Kracav4ik/tmi/cpu_init_fsm.png

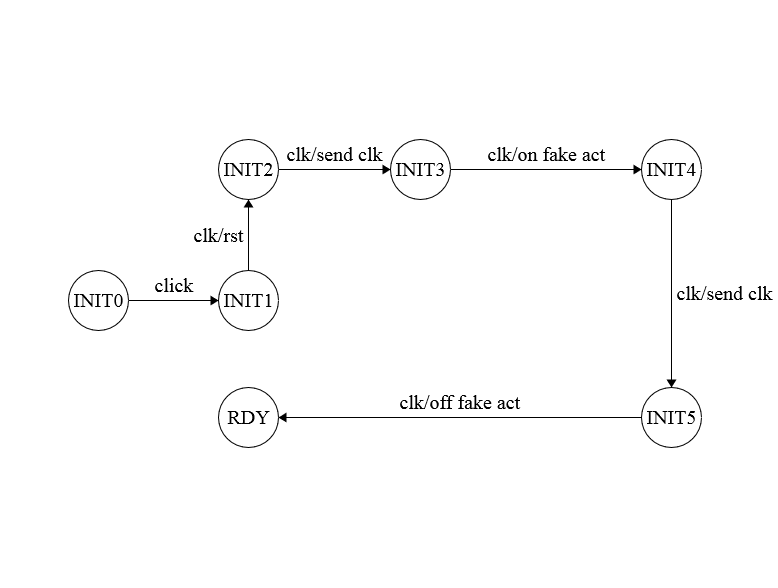
cpu_init_fsm.png
