Kracav4ik/tmi/cpu_jmp_fsm.png

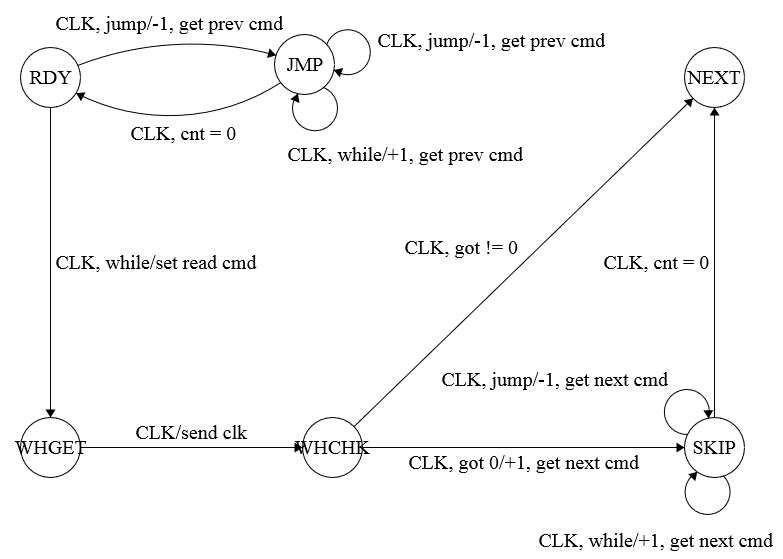
cpu_jmp_fsm.png
