Kracav4ik/tmi/cpu_kbd_fsm.png

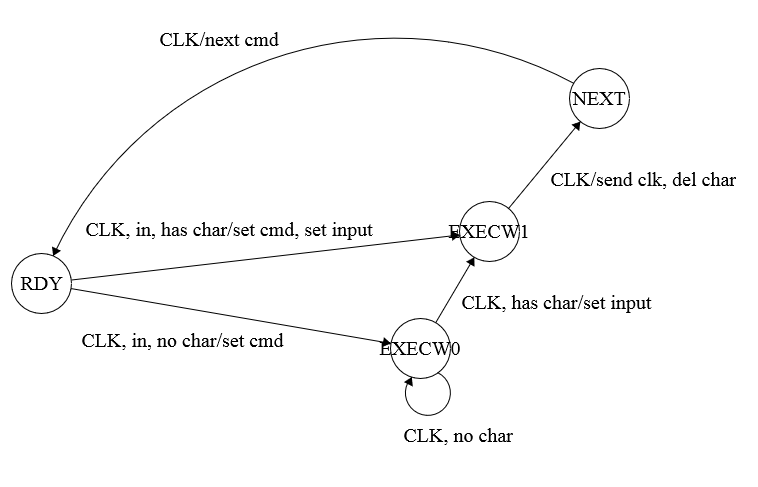
cpu_kbd_fsm.png
