Kracav4ik/tmi/cpu_simple_fsm.png

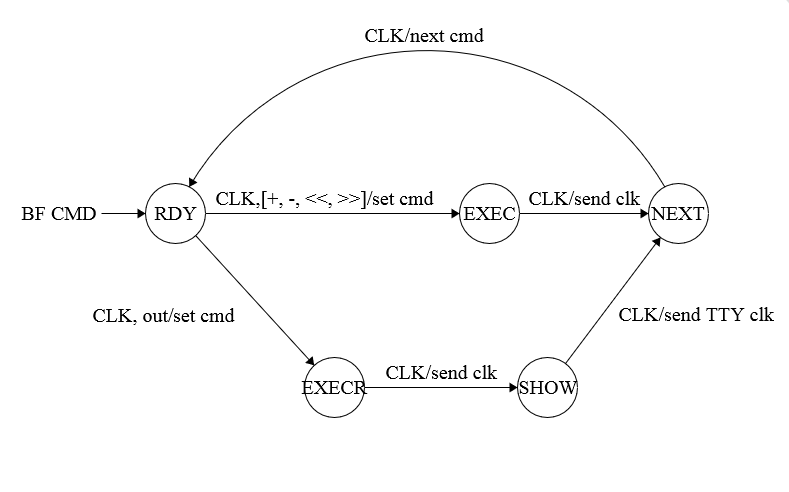
cpu_simple_fsm.png
