Kracav4ik/tmi/pics/02.png

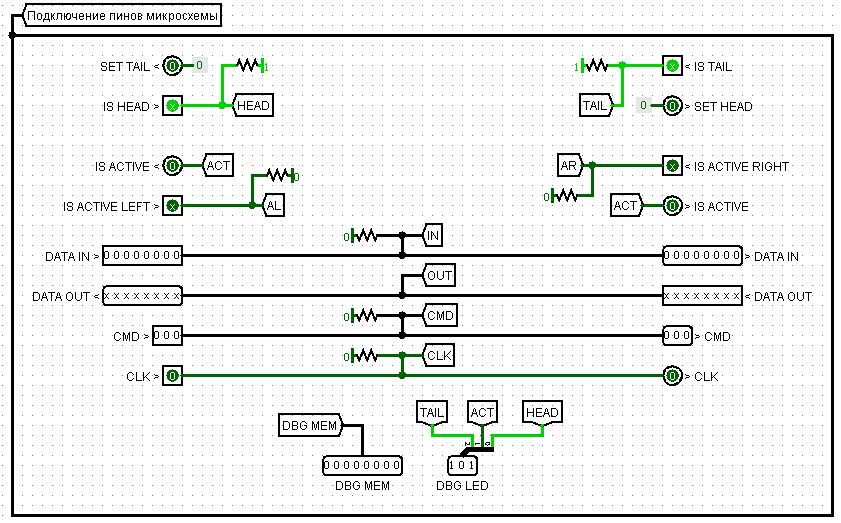
pics/02.png
