Kracav4ik/tmi/pics/03.png

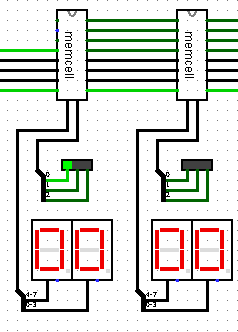
pics/03.png
