Kracav4ik/tmi/(list of files, drawings)

Other design files:
circ/tmi.circ
