Kracav4ik/tmi/(commit log)

2020-05-09 Implementation WIP
    [tmi.circ]
2020-05-10 working memcell
    [tmi.circ]
2020-05-11 init for cpu, added hello world programs
    [tmi.circ]
2020-05-11 Gdkkn, Vnqkc! (really need states in calc)
    [tmi.circ]
2020-05-12 proper states in cpu
    [tmi.circ]
2020-05-17 added command to read input, nice wire frames for logical blocks
    [tmi.circ]
2020-05-17 added commands for jump and while
    [tmi.circ]
2020-05-27 added some scripts and big mem stuff
    [tmi.circ]
2020-06-03 warp digits
    [tmi.circ]
